SiwenJadenLong/CRB-Department-of-Donuts/Donut of Doom/KiCad Files/Donut of Doom/Other Assets/ELRS Frontside.jpg

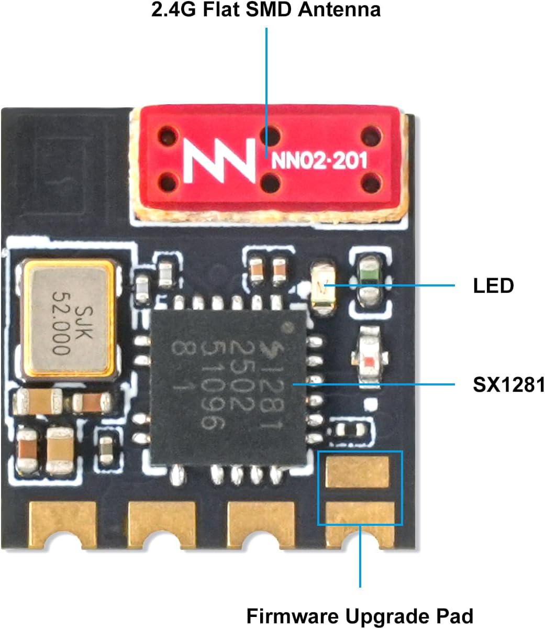
Donut of Doom/KiCad Files/Donut of Doom/Other Assets/ELRS Frontside.jpg
