SiwenJadenLong/CRB-Department-of-Donuts/Donut of Doom/CODE (openmelt2-main)/antweight_reference_platform/lid.stl

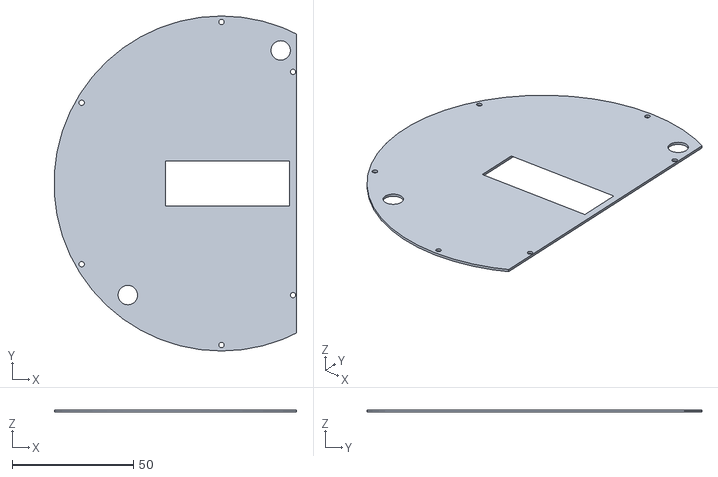
[picture p11: CAD file, 2025-09-27]
Donut of Doom/CODE (openmelt2-main)/antweight_reference_platform/lid.stl
99.9 x 138.0 x 1.00
