SiwenJadenLong/CRB-Department-of-Donuts/Donut of Doom/KiCad Files/Donut of Doom/Downloaded Libraries/H3LIS331DLTR/H3LIS331DLTR.step

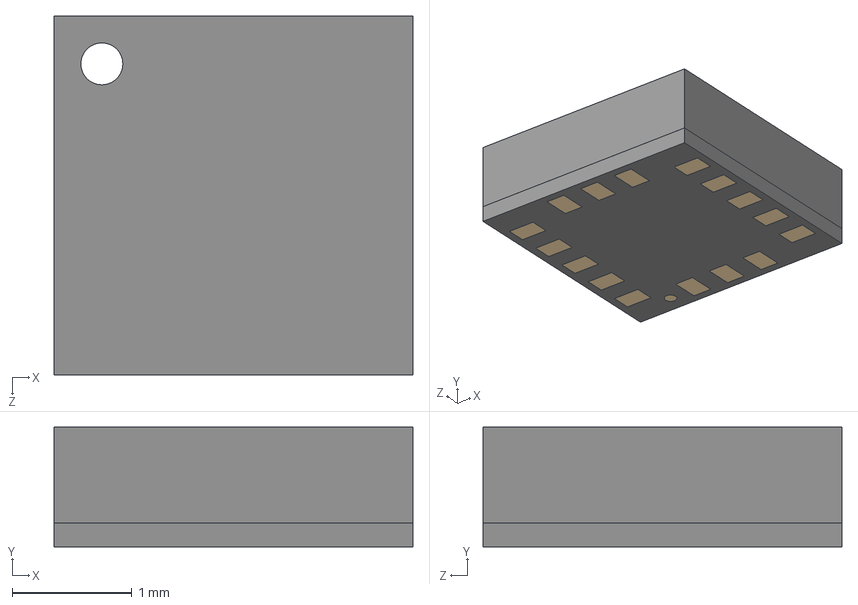
[picture p12: CAD file, 2026-01-15]
Donut of Doom/KiCad Files/Donut of Doom/Downloaded Libraries/H3LIS331DLTR/H3LIS331DLTR.step
3.00 x 1.00 x 3.00 mm
