SiwenJadenLong/CRB-Department-of-Donuts/Donut of Doom/KiCad Files/Donut of Doom/Downloaded Libraries/TL3365AF180QG/TL3365AF180QG.step

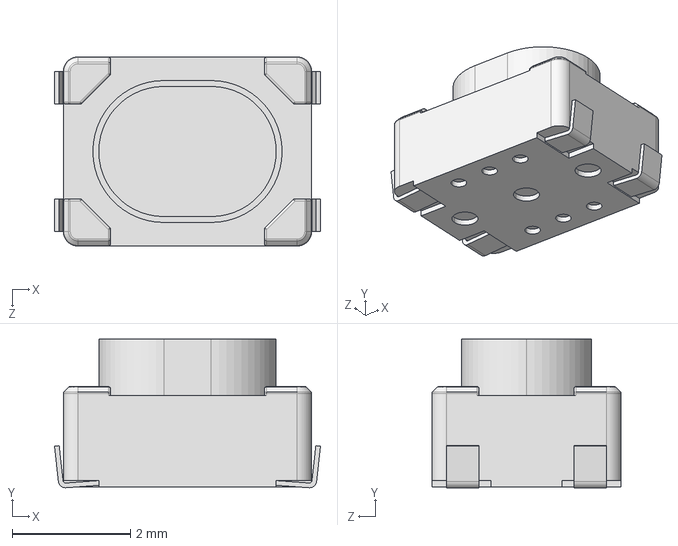
[picture p13: CAD file, 2026-01-17]
Donut of Doom/KiCad Files/Donut of Doom/Downloaded Libraries/TL3365AF180QG/TL3365AF180QG.step
4.50 x 2.51 x 3.20 mm
