SiwenJadenLong/CRB-Department-of-Donuts/Donut of Doom/KiCad Files/Donut of Doom/Downloaded Libraries/ul_MSP3V3-M3-89A/MSMP package.step

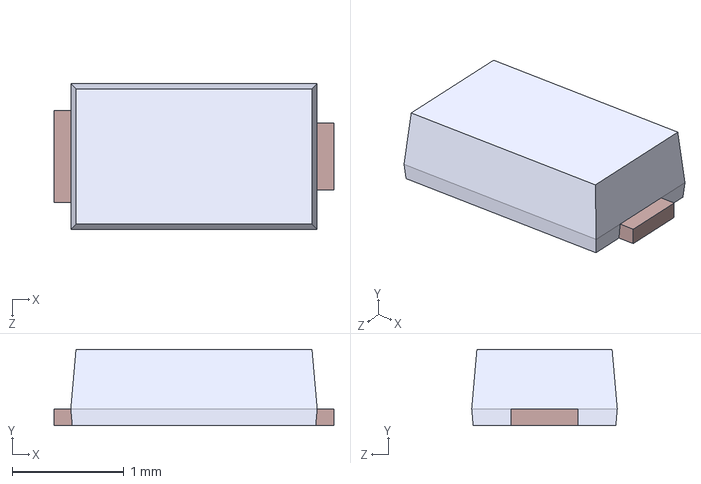
[picture p14: CAD file, 2026-01-15]
Donut of Doom/KiCad Files/Donut of Doom/Downloaded Libraries/ul_MSP3V3-M3-89A/MSMP package.step
2.50 x 0.68 x 1.30 mm
