SiwenJadenLong/CRB-Department-of-Donuts/Donut of Doom/KiCad Files/Donut of Doom/Exports/Donut of Doom Order 1.step

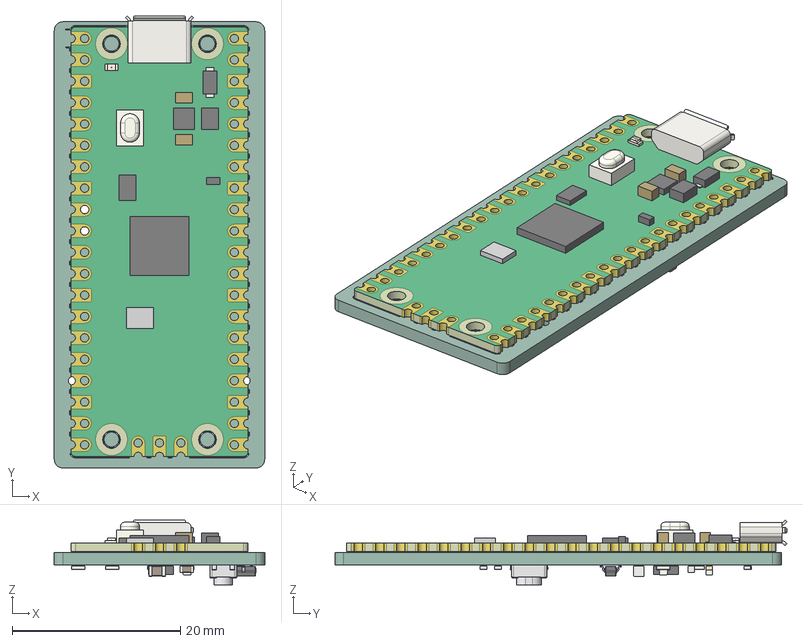
[picture p15: CAD file, 2026-01-31]
Donut of Doom/KiCad Files/Donut of Doom/Exports/Donut of Doom Order 1.step
25.0 x 53.7 x 7.70 mm
RaspberryPi_Pico
R_0603_1608Metric x 7
C_0603_1608Metric
SOT-23
LGA-16_3x3mm_P0.5mm_LayoutBorder3x5y
C_0805_2012Metric
TL3365AF180QG--3DModel-STEP-520916
LED_0603_1608Metric x 2
Donut of Doom_silkscreen
Donut of Doom_PCB
