SiwenJadenLong/CRB-Department-of-Donuts/Donut of Doom/KiCad Files/Donut of Doom/Exports/Test 1/Donut of Doom v1.step

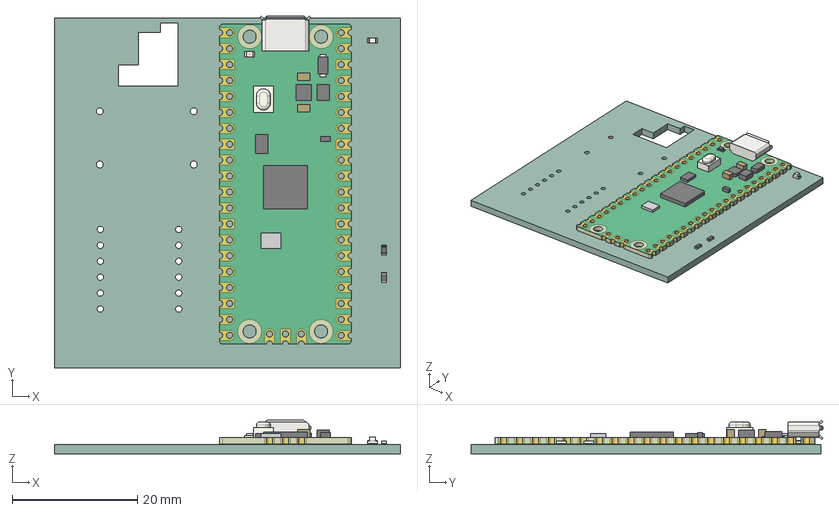
[picture p16: CAD file, 2026-01-15]
Donut of Doom/KiCad Files/Donut of Doom/Exports/Test 1/Donut of Doom v1.step
55.2 x 56.1 x 5.34 mm
RaspberryPi_Pico
R_0603_1608Metric x 2
LED_0603_1608Metric
Donut of Doom_PCB
