SiwenJadenLong/CRB-Department-of-Donuts/Donut of Doom/CODE (openmelt2-main)/antweight_reference_platform/weapon.stl

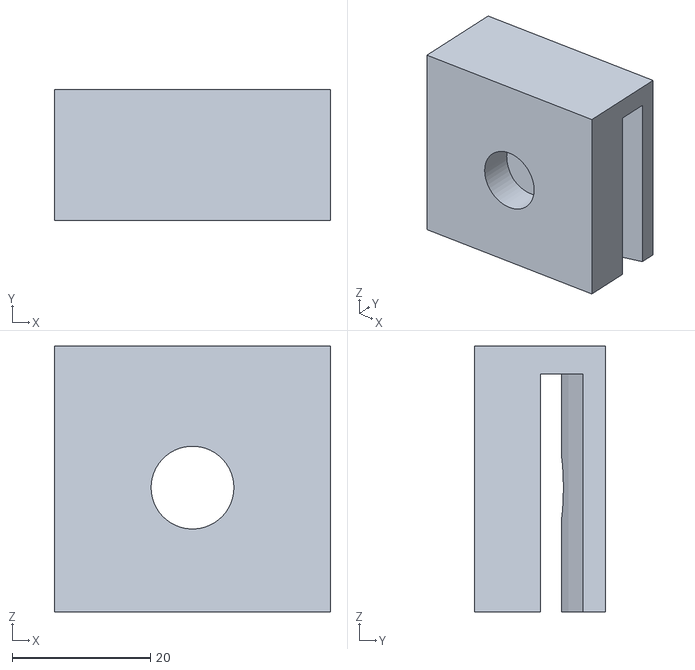
[picture p17: CAD file, 2025-09-27]
Donut of Doom/CODE (openmelt2-main)/antweight_reference_platform/weapon.stl
40.0 x 19.0 x 38.5
