SiwenJadenLong/CRB-Department-of-Donuts/Donut of Doom/CODE (openmelt2-main)/antweight_reference_platform/shell_no_weapon.stl

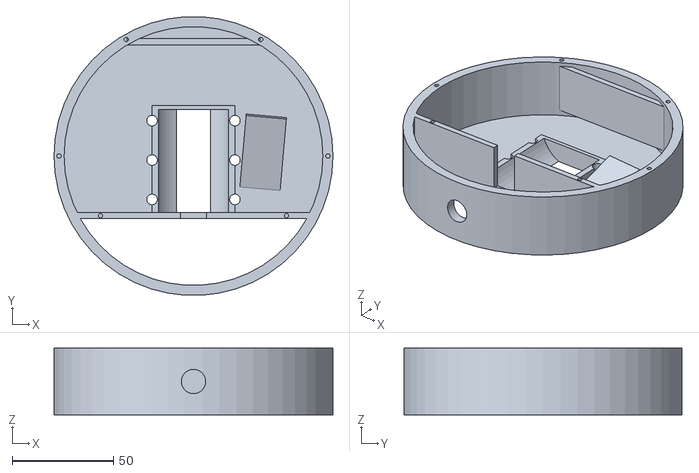
[picture p18: CAD file, 2025-09-27]
Donut of Doom/CODE (openmelt2-main)/antweight_reference_platform/shell_no_weapon.stl
138.0 x 137.7 x 33.0
