SiwenJadenLong/CRB-Department-of-Donuts/Donut of Doom/CODE (openmelt2-main)/antweight_reference_platform/shell_with_weapon.stl

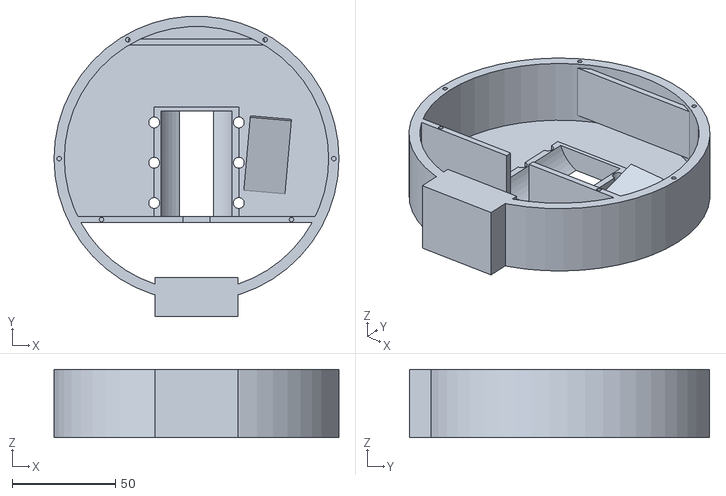
[picture p19: CAD file, 2025-09-27]
Donut of Doom/CODE (openmelt2-main)/antweight_reference_platform/shell_with_weapon.stl
138.0 x 145.4 x 33.0
