SiwenJadenLong/CRB-Department-of-Donuts/Donut of Doom/CODE (openmelt2-main)/antweight_reference_platform/weapon_pin.stl

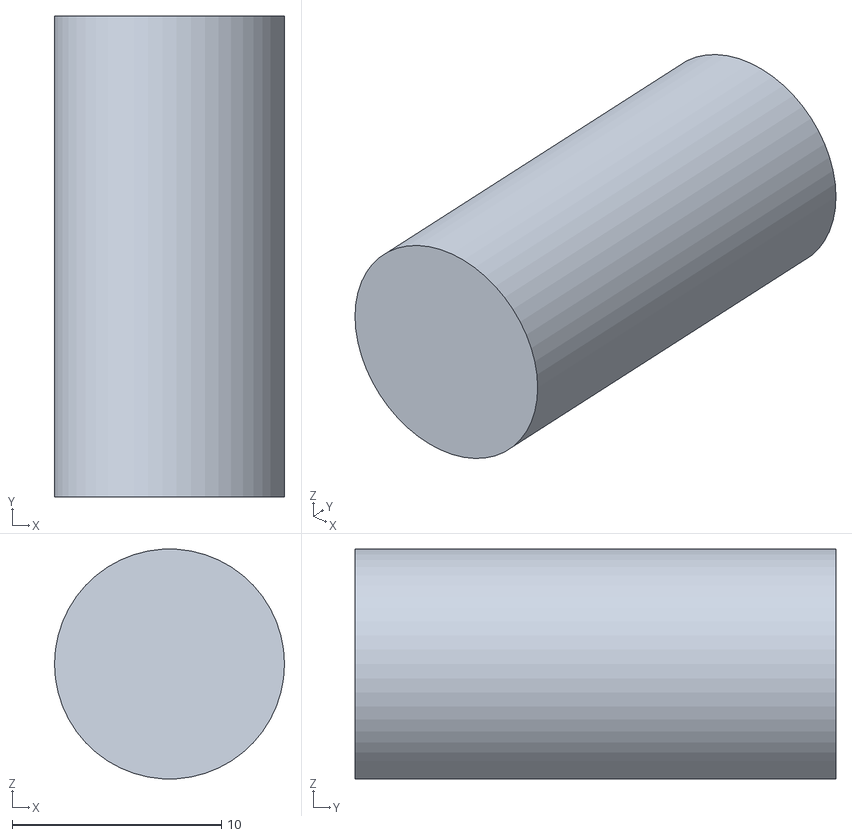
[picture p20: CAD file, 2025-09-27]
Donut of Doom/CODE (openmelt2-main)/antweight_reference_platform/weapon_pin.stl
11.0 x 23.0 x 11.0
