SiwenJadenLong/CRB-Department-of-Donuts/(list of files, cad)

Other CAD files:
Donut of Doom/CODE (openmelt2-main)/antweight_reference_platform/spinbot_ant.scad
