SiwenJadenLong/CRB-Department-of-Donuts/Donut of Doom/KiCad Files/Donut of Doom/Donut of Doom.kicad_pcb

## KiCad design Donut of Doom/KiCad Files/Donut of Doom/Donut of Doom.kicad_pcb (2026-07-06)

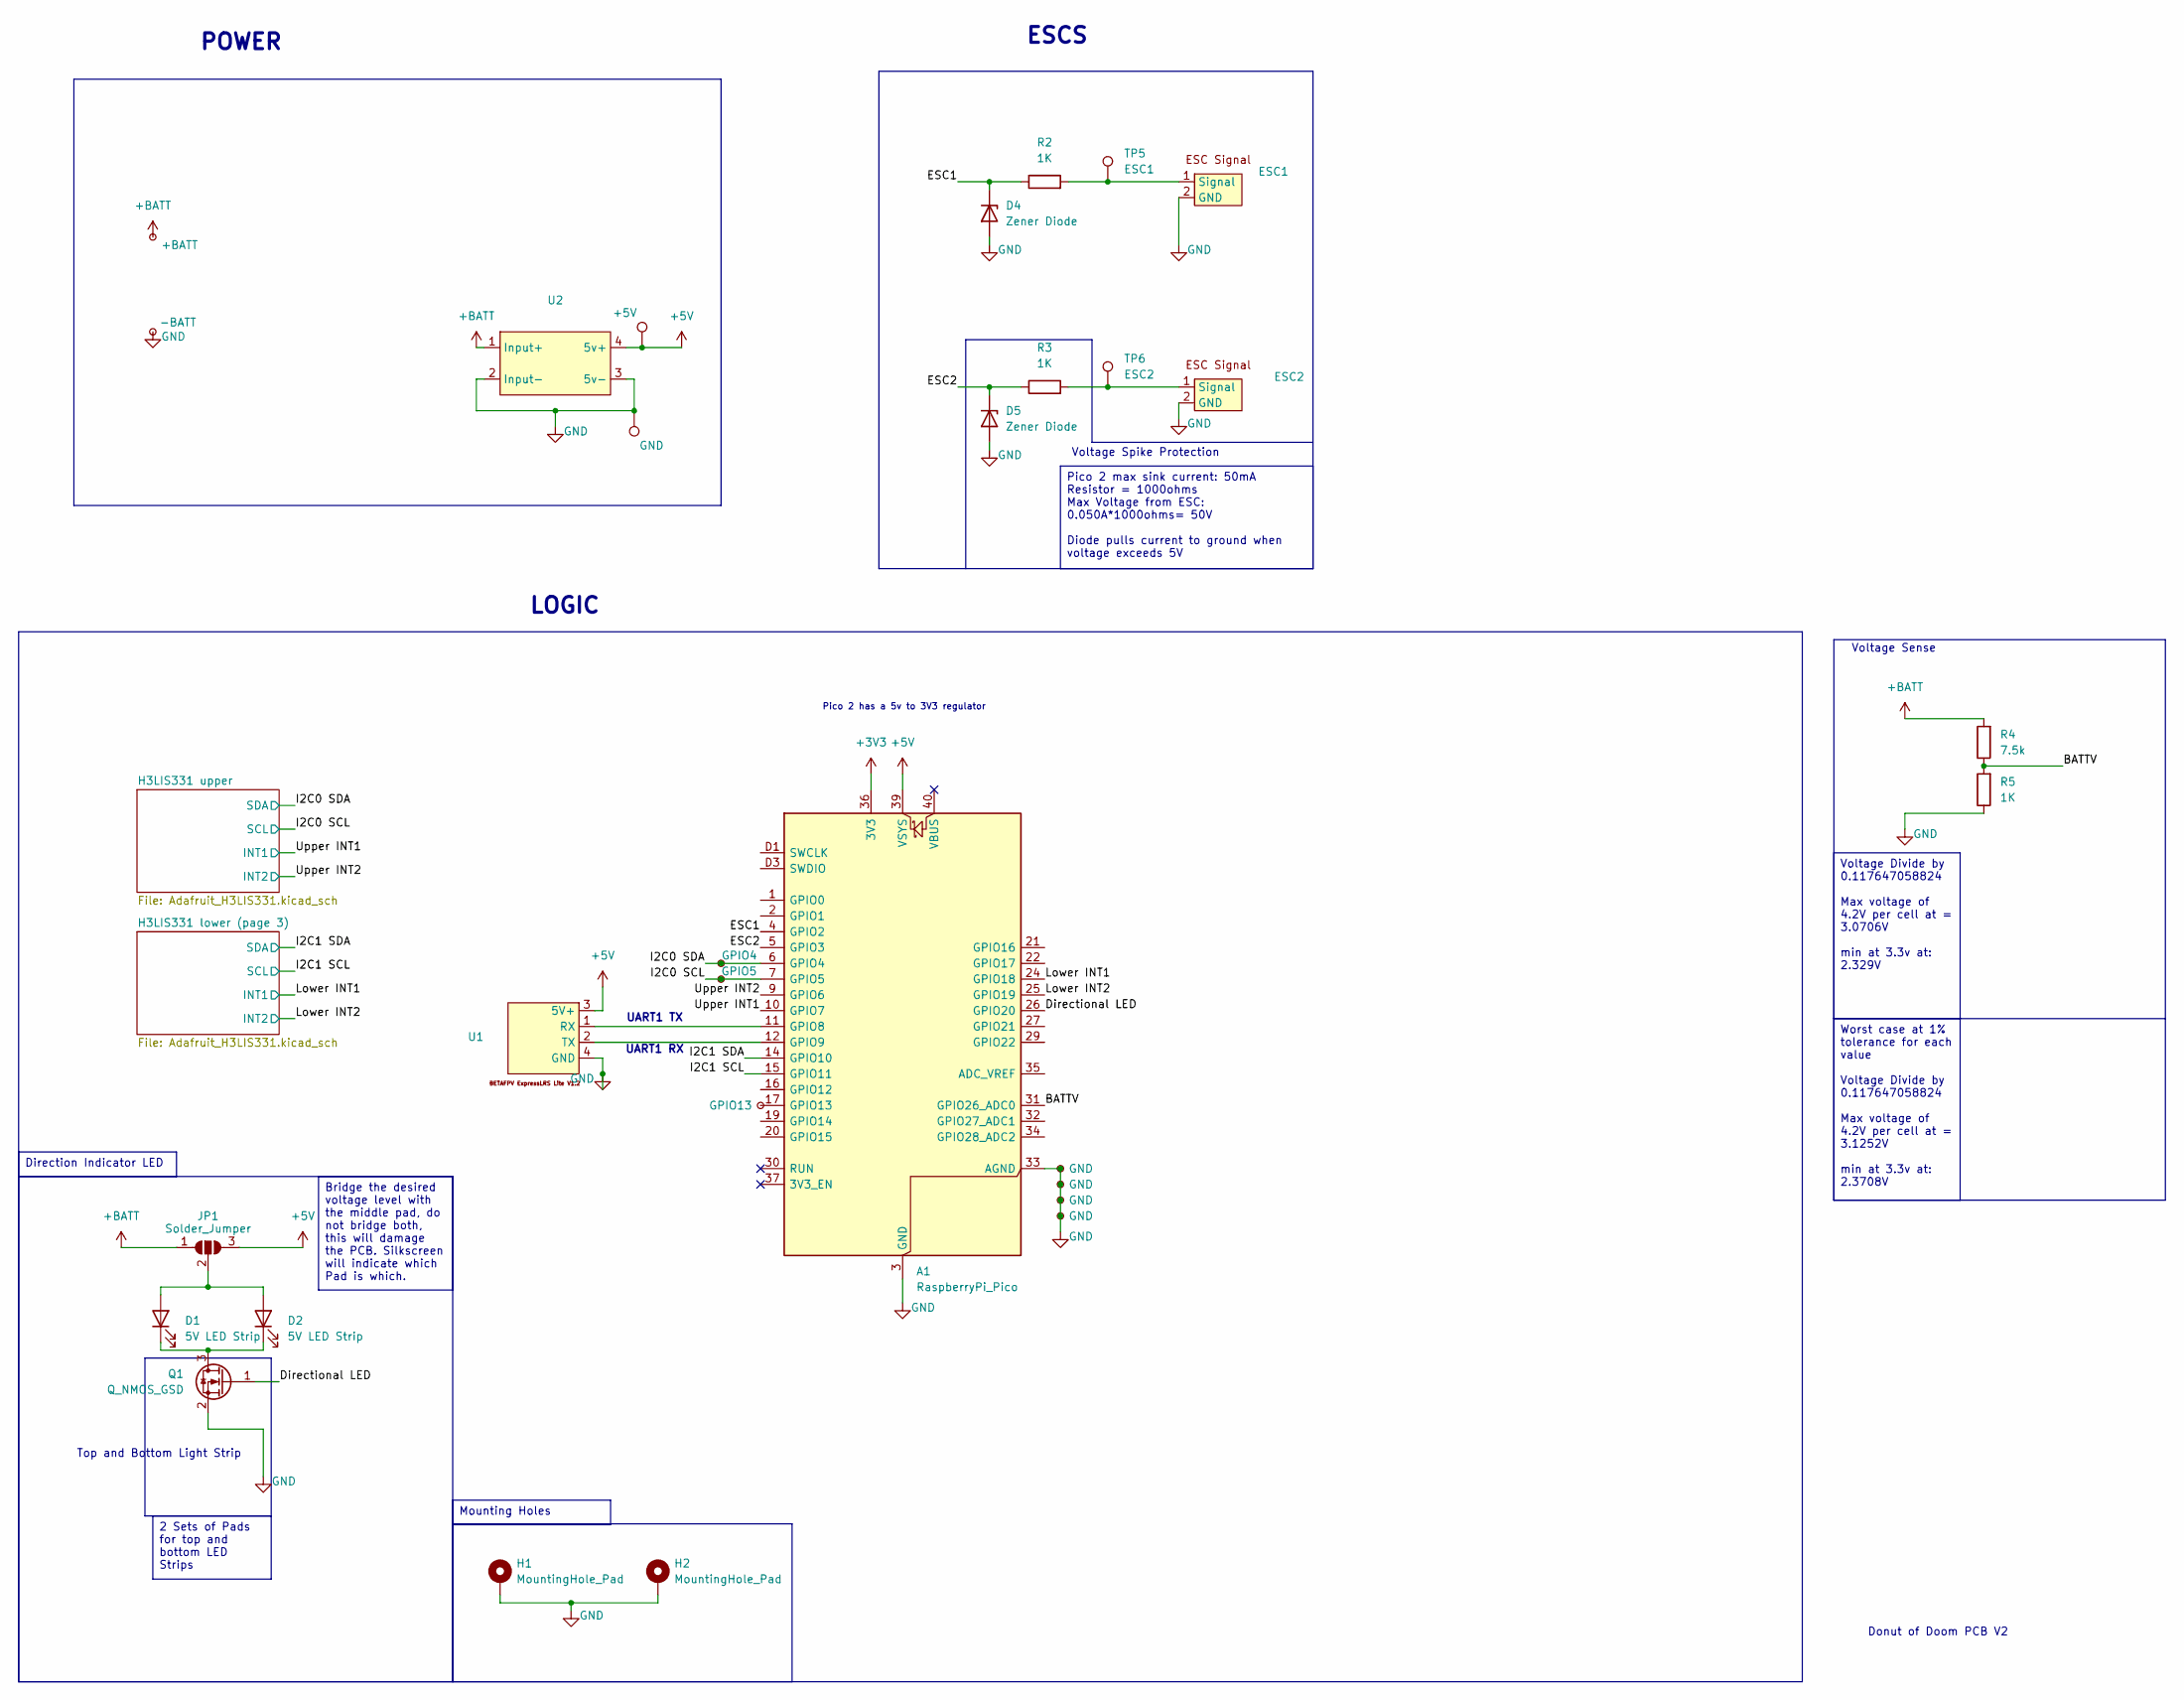
[picture p21: schematic Donut of Doom.kicad_sch]

Parts:
A1: RaspberryPi_Pico; RaspberryPi_Pico_Original_SMD_HandSolder
D1, D2: 5V LED Strip; 2 pth Pads
D4, D5: Zener Diode; SGP1610N2
ESC1, ESC2: 2_2mmx1.5mm_smd_pad
EX1: GPIO4; Pico_pth_pad
EX2: GPIO5; Pico_pth_pad
EX5: GPIO13; Pico_pth_pad
EX8, EX9, EX11, EX12: GND; Pico_pth_GND
H1, H2: MountingHole_Pad; MountingHole_2.2mm_M2_DIN965_Pad
JP1: Solder_Jumper; SolderJumper-3_P1.3mm_Open_RoundedPad1.0x1.5mm_NumberLabels
Q1: Q_NMOS_GSD; TSOT-23
R2, R3, R5: 1K; R_0603_1608Metric_Pad0.98x0.95mm_HandSolder
R4: 7.5k; R_0603_1608Metric_Pad0.98x0.95mm_HandSolder
TP1: +BATT; 3.5mmx2.5mm_oval_smd_pad
TP2: -BATT; 3.5mmx2.5mm_oval_smd_pad
TP3: GND; TestPoint_Pad_D3.0mm
TP4: +5V; TestPoint_Pad_D2.0mm
TP5: ESC1; TestPoint_Pad_D1.5mm
TP6: ESC2; TestPoint_Pad_D1.5mm
U1: BetaFPV ExpressLRS Reciever Lite V1.2
U2: 5V_Stepdown_module

Connections:
+3V3: A1.36 (3V3); also elsewhere on the board
+5V: A1.39 (VSYS), JP1.3 (B), TP4.1 (1_1), U1.3 (5V+), U2.4 (5v+)
+BATT: JP1.1 (A), R4.2, TP1.1 (1_1), U2.1 (Input+)
/BATTV: A1.31 (GPIO26_ADC0), R4.1, R5.2
/Directional LED: A1.26 (GPIO20), Q1.1 (G)
/ESC1: A1.4 (GPIO2), D4.1 (K), R2.1
/ESC2: A1.5 (GPIO3), D5.1 (K), R3.1
/I2C0 SCL: A1.7 (GPIO5), EX2.1 (1_1); also elsewhere on the board
/I2C0 SDA: A1.6 (GPIO4), EX1.1 (1_1); also elsewhere on the board
/I2C1 SCL: A1.15 (GPIO11); also elsewhere on the board
/I2C1 SDA: A1.14 (GPIO10); also elsewhere on the board
/Lower INT1: A1.24 (GPIO18); also elsewhere on the board
/Lower INT2: A1.25 (GPIO19); also elsewhere on the board
/Upper INT1: A1.10 (GPIO7); also elsewhere on the board
/Upper INT2: A1.9 (GPIO6); also elsewhere on the board
GND: A1.3 (GND), A1.8 (GND), A1.13 (GND), A1.18 (GND), A1.23 (GND), A1.28 (GND), A1.33 (AGND), A1.38 (GND), A1.D2 (GND), D4.2 (A), D5.2 (A), ESC1.2 (GND), ESC2.2 (GND), EX8.1 (1_1), EX9.1 (1_1), EX11.1 (1_1), EX12.1 (1_1), H1.1 (1_1), H2.1, Q1.2 (S), R5.1, TP2.1 (1_1), TP3.1 (1_1), U1.4 (GND), U2.2 (Input-), U2.3 (5v-); also elsewhere on the board
unnamed: A1.11 (GPIO8), U1.1 (RX)
unnamed: A1.12 (GPIO9), U1.2 (TX)
unnamed: A1.17 (GPIO13), EX5.1 (1_1)
unnamed: D1.2 (A), D2.2 (A), JP1.2 (C)
unnamed: D1.1 (K), D2.1 (K), Q1.3 (D)
unnamed: ESC1.1 (Signal), R2.2, TP5.1 (1_1)
unnamed: ESC2.1 (Signal), R3.2, TP6.1 (1_1)

Notes on the sheet:
Voltage Spike Protection
LOGIC
ESCS
UART1 RX
POWER
Pico 2 has a 5v to 3V3 regulator
Voltage Sense
Donut of Doom PCB V2
Top and Bottom Light Strip
UART1 TX
Pico 2 max sink current: 50mA Resistor = 1000ohms Max Voltage from ESC: 0.050A*1000ohms= 50V Diode pulls current to ground when voltage exceeds 5V
Worst case at 1% tolerance for each value Voltage Divide by 0.117647058824 Max voltage of 4.2V per cell at = 3.1252V min at 3.3v at: 2.3708V
Direction Indicator LED
Mounting Holes
Bridge the desired voltage level with the middle pad, do not bridge both, this will damage the PCB. Silkscreen will indicate which Pad is which.
2 Sets of Pads for top and bottom LED Strips
Voltage Divide by 0.117647058824 Max voltage of 4.2V per cell at = 3.0706V min at 3.3v at: 2.329V

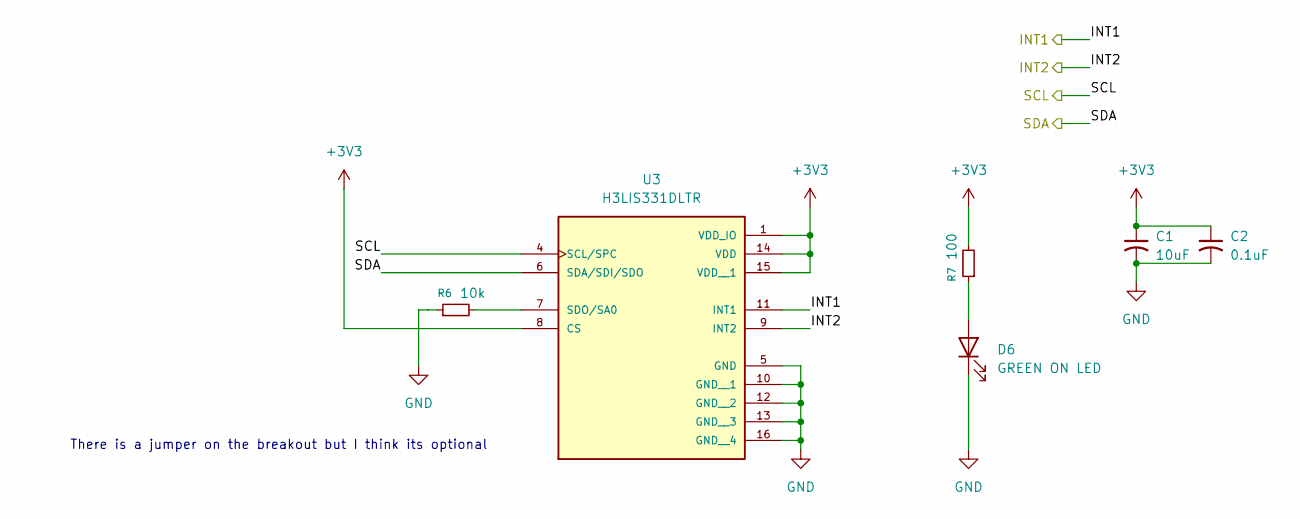
[picture p22: schematic Adafruit_H3LIS331.kicad_sch]

Parts:
C1: 10uF; C_0805_2012Metric_Pad1.18x1.45mm_HandSolder
C2: 0.1uF; C_0603_1608Metric_Pad1.08x0.95mm_HandSolder
D6: GREEN ON LED; LED_0603_1608Metric_Pad1.05x0.95mm_HandSolder
R6: 10k; R_0603_1608Metric_Pad0.98x0.95mm_HandSolder
R7: 100; R_0603_1608Metric_Pad0.98x0.95mm_HandSolder
U3: H3LIS331DLTR; LGA-16_3x3mm_P0.5mm_LayoutBorder3x5y

Connections:
+3V3: C1.1, C2.1, R7.2, U3.1 (VDD_IO), U3.8 (CS), U3.14 (VDD), U3.15 (VDD__1); also elsewhere on the board
/I2C0 SCL: U3.4 (SCL/SPC); also elsewhere on the board
/I2C0 SDA: U3.6 (SDA/SDI/SDO); also elsewhere on the board
/Upper INT1: U3.11 (INT1); also elsewhere on the board
/Upper INT2: U3.9 (INT2); also elsewhere on the board
GND: C1.2, C2.2, D6.1 (K), R6.1, U3.5 (GND), U3.10 (GND__1), U3.12 (GND__2), U3.13 (GND__3), U3.16 (GND__4); also elsewhere on the board
unnamed: D6.2 (A), R7.1
unnamed: R6.2, U3.7 (SDO/SA0)

Parts of its further copies:
C3: 10uF; C_0805_2012Metric_Pad1.18x1.45mm_HandSolder
C4: 0.1uF; C_0603_1608Metric_Pad1.08x0.95mm_HandSolder
D7: GREEN ON LED; LED_0603_1608Metric_Pad1.05x0.95mm_HandSolder
R8: 10k; R_0603_1608Metric_Pad0.98x0.95mm_HandSolder
R9: 100; R_0603_1608Metric_Pad0.98x0.95mm_HandSolder
U4: H3LIS331DLTR; LGA-16_3x3mm_P0.5mm_LayoutBorder3x5y

Connections of its further copies:
+3V3: C3.1, C4.1, R9.2, U4.1 (VDD_IO), U4.8 (CS), U4.14 (VDD), U4.15 (VDD__1); also elsewhere on the board
/I2C1 SCL: U4.4 (SCL/SPC); also elsewhere on the board
/I2C1 SDA: U4.6 (SDA/SDI/SDO); also elsewhere on the board
/Lower INT1: U4.11 (INT1); also elsewhere on the board
/Lower INT2: U4.9 (INT2); also elsewhere on the board
GND: C3.2, C4.2, D7.1 (K), R8.1, U4.5 (GND), U4.10 (GND__1), U4.12 (GND__2), U4.13 (GND__3), U4.16 (GND__4); also elsewhere on the board
unnamed: D7.2 (A), R9.1
unnamed: R8.2, U4.7 (SDO/SA0)

Notes on the sheet:
There is a jumper on the breakout but I think its optional

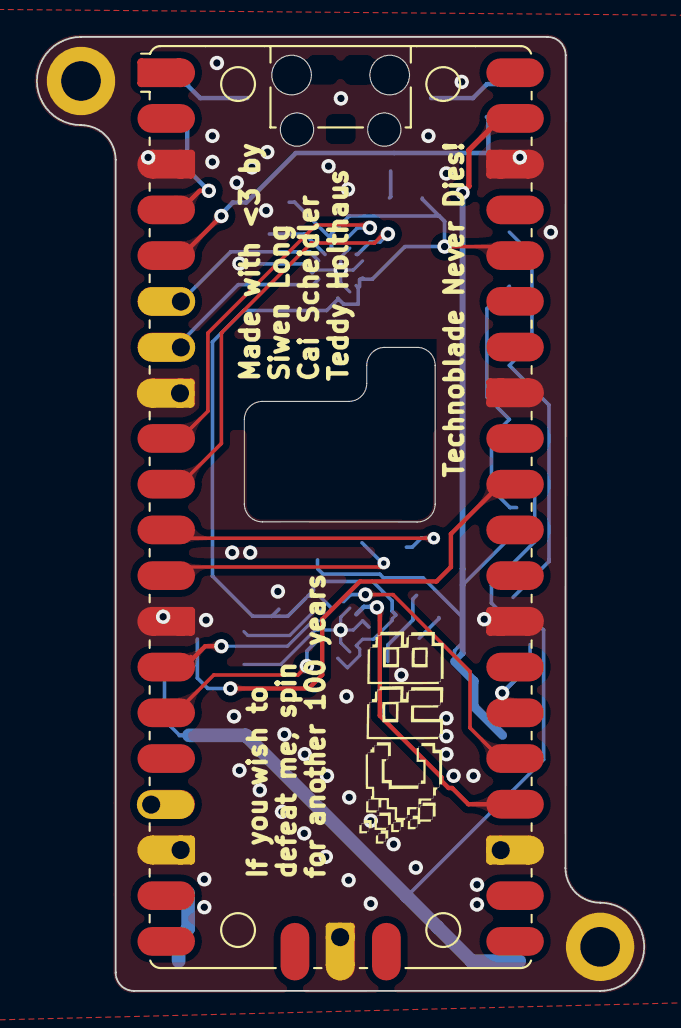
[picture p23: board Donut of Doom.kicad_pcb from above]

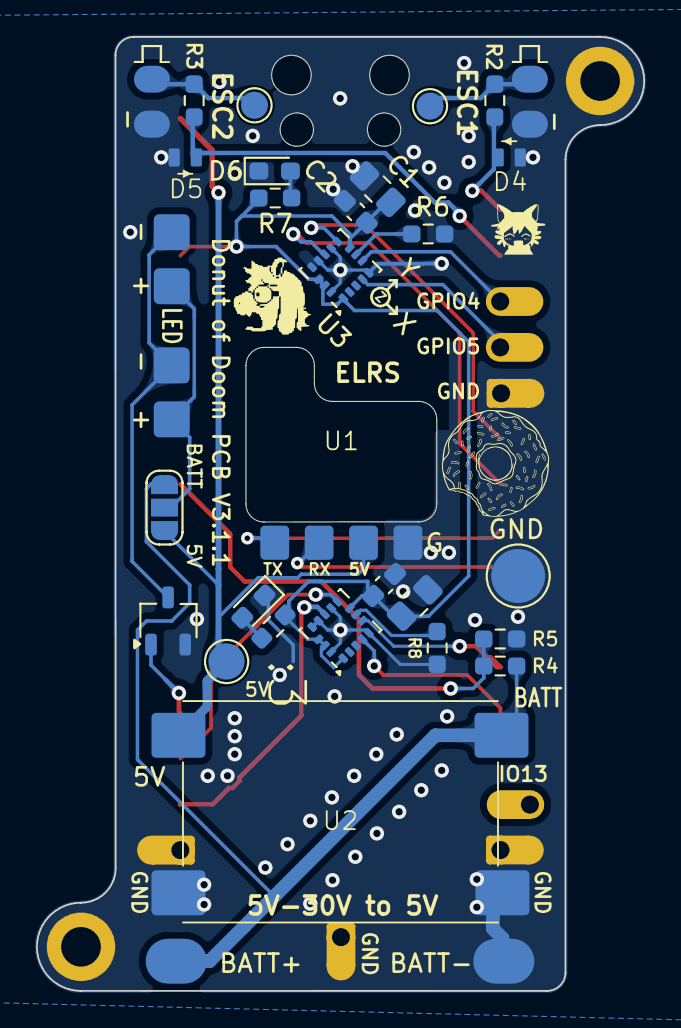
[picture p24: board Donut of Doom.kicad_pcb from below]

Board: 2 copper layers, 33.7 x 53.0 mm, 42 parts (32 on the bottom side), 27 nets.

Other parts of the board:
H1#2: MountingHole_Pad; MountingHole_2.2mm_M2_DIN965_Pad

Their connections:
GND: H1#2.1 (1_1); also elsewhere on the board
