SiwenJadenLong/CRB-Department-of-Donuts/Donut of Doom/CODE (openmelt2-main)/openmelt/melty_config.h

#include <SparkFun_LIS331.h>

#include <FastIMU.h>

#include <Adafruit_SleepyDog.h>

//This file is intended to include all commonly modified settings for Open Melt

#ifndef MELTY_CONFIG_GUARD  //header guard
#define MELTY_CONFIG_GUARD

//----------AVR SPECIFIC FUNCTIONALITY----------
//This code has not been tested on ARM / non-AVR Arduinos (but may work)
//Doesn't currently support persistent config storage for non-AVR Arduinos (see config_storage.cpp for details)
//490Hz PWM-throttle behavior is specific to Atmega32u4 (see below)

//----------DIAGNOSTICS----------
//#define JUST_DO_DIAGNOSTIC_LOOP                 //Disables the robot / just displays config / battery voltage / RC info via serial

//----------EEPROM----------
//#define ENABLE_EEPROM_STORAGE                     //Comment out this to disable EEPROM (for ARM)
#define EEPROM_WRITTEN_SENTINEL_VALUE 42          //Changing this value will cause existing EEPROM values to be invalidated (revert to defaults)

//----------TRANSLATIONAL DRIFT SETTINGS----------
//"DEFAULT" values are overriden by interactive config / stored in EEPROM (interactive config will be easier if they are about correct)
//To force these values to take effect after interactive config - increment EEPROM_WRITTEN_SENTINEL_VALUE
#define DEFAULT_ACCEL_MOUNT_RADIUS_CM 4.45         //Radius of accelerometer from center of robot
#define DEFAULT_LED_OFFSET_PERCENT 7              //Adjust to make heading LED line up with direction robot travels 0-99 (increasing moves beacon clockwise)
                                                   
#define DEFAULT_ACCEL_ZERO_G_OFFSET 1.5f          //Value accelerometer returns with robot at rest (in G) - adjusts for any offset
                                                  //H3LIS331 claims +/-1g DC offset - typical - but +/-2.5 has been observed at +/-400g setting (enough to cause tracking error)
                                                  //Just enterring and exiting config mode will automatically set this value / save to EEPROM (based on current accel reading reflecting 0g)
                                                  //For small-radius bots - try changing to H3LIS331 to +/-200g range for improved accuracy (accel_handler.h)

#define LEFT_RIGHT_HEADING_CONTROL_DIVISOR 1.5f   //How quick steering is (larger values = slower)

#define MIN_TRANSLATION_RPM 400                   //full power spin in below this number (increasing can reduce spin-up time)


//----------PIN MAPPINGS----------
//RC pins must be Arduino interrupt pins
//we need 3 interrupt pins - which requires an Arduino with Atmega32u4 or better (Atmega328 only support 2 interrupts)
//Common RC receiver setup LEFTRIGHT = CH1, FORBACK = CH2, THROTTLE = CH3
//Note: Accelerometer is connected with default Arduino SDA / SCL pins

#define LEFTRIGHT_RC_CHANNEL_PIN 4 // Channel 1, Purple                 //To Left / Right on RC receiver
#define FORBACK_RC_CHANNEL_PIN 5 // Channel 2, White                    //To Forward / Back on RC receiver (Pin 1 on Arduino Micro labelled as "TX" - https://docs.arduino.cc/hacking/hardware/PinMapping32u4)
#define THROTTLE_RC_CHANNEL_PIN 17 // Channel 4, Yellow                 //To Throttle on RC receiver (Pin 0 on Arduino Micro labelled as "RX" - https://docs.arduino.cc/hacking/hardware/PinMapping32u4)
#define KILLSWITCH_RC_CHANNEL_PIN 16 // Channel 3, Brown

#define HEADING_LED_PIN	2                         //To heading LED (pin 13 is on-board Arduino LED)

//no configuration changes are needed if only 1 motor is used!
#define MOTOR_PIN1 18 // Mustard                             //Pin for Motor 1 driver
#define MOTOR_PIN2 19 // Also Mustard                            //Pin for Motor 2 driver

#define BATTERY_ADC_PIN A0                        //Pin for battery monitor (if enabled)


//----------THROTTLE CONFIGURATION----------
//THROTTLE_TYPE / High-speed PWM motor driver support: b
//Setting THROTTLE_TYPE to FIXED_PWM_THROTTLE or DYNAMIC_PWM_THROTTLE pulses 490Hz PWM signal on motor drive pins at specified duty cycle (0-255)
//Can be used for 2 possible purposes:
//  1. Used as control signal for a brushless ESC supporting high speed (490Hz) PWM (tested with Hobbypower 30A / "Simonk" firmware)
//          Assumes Arduino PWM output is 490Hz (such as Arduino Micro pins 9 and 10) - should be expected NOT to work with non-AVR Arduino's without changes
//  2. 490hz signal maybe fed into a MOSFET or other on / off motor driver to control drive strength (relatively low frequency)
//Thanks to Richard Wong for his research in implementing brushless ESC support

enum throttle_modes {
  BINARY_THROTTLE,      //Motors pins are fully on/off - throttle controlled by portion of each rotation motor is on (no PWM)

  FIXED_PWM_THROTTLE,   //Motors pins are PWM at PWM_MOTOR_ON, PWM_MOTOR_COAST or PWM_MOTOR_OFF
                        //throttle controlled by portion of each rotation motor is on

  DYNAMIC_PWM_THROTTLE  //Scales PWM throttling between PWM_MOTOR_COAST and PWM_MOTOR_ON
                        //Range of throttle scaled over is determined by DYNAMIC_PWM_THROTTLE_PERCENT_MAX
                        //PWM is locked at PWM_MOTOR_ON for throttle positions higher than DYNAMIC_PWM_THROTTLE_PERCENT_MAX
                        //Robot speed is additionally controlled by portion of each rotation motor is on (unless DYNAMIC_PWM_MOTOR_ON_PORTION is defined)
                        //This mode reduces current levels during spin up at part throttle
};

#define THROTTLE_TYPE FIXED_PWM_THROTTLE      //<---Throttle type set here!

#define DYNAMIC_PWM_MOTOR_ON_PORTION 0.75f       //if defined (and DYNAMIC_PWM_THROTTLE is set) portion of each rotation motor is on is fixed at this value
                                                //About 0.5f for best translation (higher for increased RPM)

#define DYNAMIC_PWM_THROTTLE_PERCENT_MAX 0.5f   //Range of RC throttle DYNAMIC_PWM_THROTTLE is applied to 
                                                //0.5f for 0-50% throttle (full PWM_MOTOR_ON used for >50% throttle)
                                                //1.0f for 0-100% throttle

//----------PWM MOTOR SETTINGS---------- 
//(only used if a PWM throttle mode is chosen)
//PWM values are 0-255 duty cycle
#define PWM_MOTOR_ON 31                          //Motor PWM ON duty cycle (Simonk: 140 seems barely on / 230 seems a good near-full-throttle value)
#define PWM_MOTOR_COAST 15                      //Motor PWM COAST duty cycle - set to same as PWM_ESC_MOTOR_OFF for fully unpowered (best translation?)
#define PWM_MOTOR_OFF 15                        //Motor PWM OFF duty cycle (Simonk: 100 worked well in testing - if this is too low - ESC may not init)


//----------BATTERY MONITOR----------
#define BATTERY_ALERT_ENABLED                     //if enabled - heading LED will flicker when battery voltage is low
#define VOLTAGE_DIVIDER 11                        //(~10:1 works well - 10kohm to GND, 100kohm to Bat+).  Resistors have tolerances!  Adjust as needed...
#define BATTERY_ADC_WARN_VOLTAGE_THRESHOLD 7.0f  //If voltage drops below this value - then alert is triggered
#define ARDUINIO_VOLTAGE 5.0f                     //Needed for ADC maths for battery monitor
#define LOW_BAT_REPEAT_READS_BEFORE_ALARM 20      //Requires this many ADC reads below threshold before alarming


//----------SAFETY----------
#define ENABLE_WATCHDOG                           //Uses Adafruit's sleepdog to enable watchdog / reset (tested on AVR - should work for ARM https://github.com/adafruit/Adafruit_SleepyDog)
#define WATCH_DOG_TIMEOUT_MS 2000                 //Timeout value for watchdog (not all values are supported - 2000ms verified with Arudino Micro)
#define VERIFY_RC_THROTTLE_ZERO_AT_BOOT           //Requires RC throttle be 0% at boot to allow spin-up for duration of MAX_MS_BETWEEN_RC_UPDATES (about 1 second)
                                                  //Intended as safety feature to prevent bot from spinning up at power-on if RC was inadvertently left on.
                                                  //Downside is if unexpected reboot occurs during a fight - driver will need to set throttle to zero before power 

#endif
