SiwenJadenLong/CRB-Department-of-Donuts/Donut of Doom/CODE (openmelt2-main)/openmelt/spin_control.cpp

//this module handles calculation and timing loop for translational drift
//direction of rotation assumed to be CLOCKWISE (but should work counter-clockwise)

#include "arduino.h"
#include "melty_config.h"
#include "motor_driver.h"
#include "rc_handler.h"
#include "spin_control.h"
#include "accel_handler.h"
#include "config_storage.h"
#include "led_driver.h"
#include "battery_monitor.h"

#define ACCEL_MOUNT_RADIUS_MINIMUM_CM 0.2                 //Never allow interactive config to set below this value
#define LEFT_RIGHT_CONFIG_RADIUS_ADJUST_DIVISOR 50.0f     //How quick accel. radius is adjusted in config mode (larger values = slower)
#define LEFT_RIGHT_CONFIG_LED_ADJUST_DIVISOR 0.1f         //How quick LED heading is adjusted in config mode (larger values = slower)

#define MAX_TRANSLATION_ROTATION_INTERVAL_US (1.0f / MIN_TRANSLATION_RPM) * 60 * 1000 * 1000
#define MAX_TRACKING_ROTATION_INTERVAL_US MAX_TRANSLATION_ROTATION_INTERVAL_US * 2   //don't track heading if we are this slow (also puts upper limit on time spent in melty loop for safety)

static float accel_mount_radius_cm = DEFAULT_ACCEL_MOUNT_RADIUS_CM;
static float accel_zero_g_offset = DEFAULT_ACCEL_ZERO_G_OFFSET;
static float led_offset_percent = DEFAULT_LED_OFFSET_PERCENT;         //stored in EEPROM as an INT - but handled as a float for configuration purposes

static unsigned int highest_rpm = 0;
static bool config_mode = false;   //1 if we are in config mode

//loads settings from EEPROM
void load_melty_config_settings() {
#ifdef ENABLE_EEPROM_STORAGE 
  accel_mount_radius_cm = load_accel_mount_radius();
  accel_zero_g_offset = load_accel_zero_g_offset();
  led_offset_percent = load_heading_led_offset();
  // Serial.println("LOADING CONFIGURED SETTINGS FROM EEPROM!");
  // Serial.print("accel_mount_radius_cm: "); Serial.println(accel_mount_radius_cm);
  // Serial.print("accel_zero_g_offset: "); Serial.println(accel_zero_g_offset);
  // Serial.print("led_offset_percent: "); Serial.println(led_offset_percent);
#endif  
}

//saves settings to EEPROM
void save_melty_config_settings() {
#ifdef ENABLE_EEPROM_STORAGE 
  save_settings_to_eeprom(led_offset_percent, accel_mount_radius_cm, accel_zero_g_offset);
#endif  
}

//updated the expected accelerometer reading for 0g 
//assumes robot is not spinning when config mode is entered
//value saved to EEPROM on config mode exit
static void update_accel_zero_g_offset(){
  int offset_samples = 200;
  for (int accel_sample_loop = 0; accel_sample_loop < offset_samples; accel_sample_loop ++) {
    accel_zero_g_offset += get_accel_force_g();
  }
  accel_zero_g_offset = accel_zero_g_offset / offset_samples;
}

void toggle_config_mode() {
  config_mode = !config_mode;

  //on entering config mode - update the zero g offset
  if (config_mode) update_accel_zero_g_offset();
  
  //enterring or exiting config mode also resets highest observed RPM
  highest_rpm = 0;
}

bool get_config_mode() {
  return config_mode;
}

int get_max_rpm() {
  return highest_rpm;
}

//calculates time for this rotation of robot
//robot is steered by increasing / decreasing rotation by factor relative to RC left / right position
//ie - reducing rotation time estimate below actual results in shift of heading opposite the direction of rotation
static float get_rotation_interval_ms(int steering_disabled) {
  
  float radius_adjustment_factor = 0;

  //don't adjust steering if disabled by config mode - or we are in RC deadzone
  if (steering_disabled == 0 && rc_get_is_lr_in_normal_deadzone() == false) {
    radius_adjustment_factor = (float)(rc_get_leftright() / (float)NOMINAL_PULSE_RANGE) / LEFT_RIGHT_HEADING_CONTROL_DIVISOR;
  }
  
  float effective_radius_in_cm = accel_mount_radius_cm;// + 4 * (float)(rc_get_leftright()/500.0f);
  //Serial.print("effective_radius_in_cm: "); Serial.println(effective_radius_in_cm);
  
  effective_radius_in_cm = effective_radius_in_cm + (effective_radius_in_cm * radius_adjustment_factor);

  float rpm;
  //use of absolute makes it so we don't need to worry about accel orientation
  //calculate RPM from g's - derived from "G = 0.00001118 * r * RPM^2"
  rpm = fabs(get_accel_force_g() - accel_zero_g_offset) * 89445.0f;
  //rpm = fabs(25 - accel_zero_g_offset) * 89445.0f;
  rpm = rpm / effective_radius_in_cm;
  rpm = sqrt(rpm);

  if (rpm > highest_rpm || highest_rpm == 0) highest_rpm = rpm;

  float rotation_interval = (1.0f / rpm) * 60 * 1000;
  return rotation_interval;
}


//performs changes to melty parameters when in config mode
static struct melty_parameters_t handle_config_mode(struct melty_parameters_t melty_parameters) {

  //if forback forward - normal drive (for driver testing - no adjustment of melty parameters)

  //if forback neutral - then do radius adjustment
  Serial.println("HANDLING CONFIG MODE");
  if (melty_parameters.translate_forback == RC_FORBACK_NEUTRAL) {
      Serial.println("ADJUSTING ACCEL RADIUS");
    //radius adjustment overrides steering
    melty_parameters.steering_disabled = 1;

    //only adjust if stick is outside deadzone    
    if (rc_get_is_lr_in_config_deadzone() == false) {
      //show that we are changing config
      melty_parameters.led_shimmer = 1;

      float adjustment_factor = (accel_mount_radius_cm * (float)(rc_get_leftright() / (float)NOMINAL_PULSE_RANGE));
      adjustment_factor = adjustment_factor / LEFT_RIGHT_CONFIG_RADIUS_ADJUST_DIVISOR;
      accel_mount_radius_cm = accel_mount_radius_cm + adjustment_factor;
      Serial.println("REALLY ADJUSTING ACCEL RADIUS");
      Serial.print("accel_mount_radius_cm: "); Serial.println(accel_mount_radius_cm);

      if (accel_mount_radius_cm < ACCEL_MOUNT_RADIUS_MINIMUM_CM) accel_mount_radius_cm = ACCEL_MOUNT_RADIUS_MINIMUM_CM;
    }    
  }
  
  //if forback backward - do LED heading adjustment (don't translate)
  if (melty_parameters.translate_forback == RC_FORBACK_BACKWARD) {
    Serial.println("ADJUSTING LED HEADING");
    //LED heading offset adjustment overrides steering
    melty_parameters.steering_disabled = 1;
    
    //only adjust if stick is outside deadzone  
    if (rc_get_is_lr_in_config_deadzone() == false) {

      //disable translation if adjusting heading
      melty_parameters.translate_forback = RC_FORBACK_NEUTRAL;

      //show that we are changing config
      melty_parameters.led_shimmer = 1;

      float adjustment_factor =  (float)(rc_get_leftright() / (float)NOMINAL_PULSE_RANGE);
      adjustment_factor = adjustment_factor / LEFT_RIGHT_CONFIG_LED_ADJUST_DIVISOR;
      led_offset_percent = led_offset_percent + adjustment_factor;

      Serial.println("REALLY ADJUSTING LED HEADING");
      Serial.print("led_offset_percent: "); Serial.println(led_offset_percent);

      if (led_offset_percent > 99) led_offset_percent = 0;
      if (led_offset_percent < 0) led_offset_percent = 99;

    }
  }    
  return melty_parameters;  
}

//Calculates all parameters need for a single rotation (motor timing, LED timing, etc.)
//This entire section takes ~1300us on an Atmega32u4 (acceptable - fast enough to not have major impact on tracking accuracy)
static struct melty_parameters_t get_melty_parameters(void) {

  struct melty_parameters_t melty_parameters = {};

  float led_offset_portion = led_offset_percent / 100.0f;

  melty_parameters.throttle_percent = rc_get_throttle_percent() / 100.0f;

  //by default motor_on_portion maps to thottle_percent input - but that can be altered
  float motor_on_portion = melty_parameters.throttle_percent;

  //changes motor_on_portion to fixed value if we are throttling via PWM if DYNAMIC_PWM_MOTOR_ON_PORTION is defined
#ifdef DYNAMIC_PWM_MOTOR_ON_PORTION
  if (THROTTLE_TYPE == DYNAMIC_PWM_THROTTLE) {
    motor_on_portion = DYNAMIC_PWM_MOTOR_ON_PORTION;
  }
#endif 

  float led_on_portion = melty_parameters.throttle_percent;  //LED width changed with throttle percent
  if (led_on_portion < 0.10f) led_on_portion = 0.10f;
  if (led_on_portion > 0.90f) led_on_portion = 0.90f;

  melty_parameters.translate_forback = rc_get_forback();

  //if we are in config mode - handle it (and disable steering if needed)
  if (get_config_mode() == true) {
    melty_parameters = handle_config_mode(melty_parameters);
  }

  melty_parameters.rotation_interval_us = get_rotation_interval_ms(melty_parameters.steering_disabled) * 1000;
  
  //if under defined RPM - just try to spin up (motors on for full rotation)
  // if (melty_parameters.rotation_interval_us > MAX_TRANSLATION_ROTATION_INTERVAL_US){
  //   heading_led_on(0);
  //   motor_on_portion = 1;
  // } 

  //if we are too slow - don't even try to track heading
  // if (melty_parameters.rotation_interval_us > MAX_TRACKING_ROTATION_INTERVAL_US) {
  //   melty_parameters.rotation_interval_us = MAX_TRACKING_ROTATION_INTERVAL_US;
  // }

  unsigned long motor_on_us = motor_on_portion * melty_parameters.rotation_interval_us;
  unsigned long led_on_us = led_on_portion * melty_parameters.rotation_interval_us;
  unsigned long led_offset_us = led_offset_portion * melty_parameters.rotation_interval_us;

  //starts LED on time at point in rotation so it's "centered" on led offset
  if (led_on_us / 2 <= led_offset_us) {
    melty_parameters.led_start = led_offset_us - (led_on_us / 2);
  } else {
    melty_parameters.led_start = (melty_parameters.rotation_interval_us + led_offset_us) - (led_on_us / 2);
  }
  
  melty_parameters.led_stop = melty_parameters.led_start + led_on_us;

  //"wraps" led off time if it exceeds rotation length
  if (melty_parameters.led_stop > melty_parameters.rotation_interval_us)
    melty_parameters.led_stop = melty_parameters.led_stop - melty_parameters.rotation_interval_us;

  //phase 1 timing: for motor_1 in forward translation or motor_2 in reverse
  //motor "on" period is centered at the halfway point of the rotation cycle (6 o'clock)
  melty_parameters.motor_start_phase_1 = (melty_parameters.rotation_interval_us / 2) - (motor_on_us / 2);
  melty_parameters.motor_stop_phase_1 = melty_parameters.motor_start_phase_1 + motor_on_us;

  //phase 2 timing: for motor_2 in forward translation or motor_1 in reverse
  //180-degree phase shift relative to phase 1, centering the "on" period at the cycle's start/end (12 o'clock)
  melty_parameters.motor_start_phase_2 = melty_parameters.rotation_interval_us - (motor_on_us / 2);
  melty_parameters.motor_stop_phase_2 = motor_on_us / 2;

  //if the battery voltage is low - shimmer the LED to let user know
#ifdef BATTERY_ALERT_ENABLED
  if (battery_voltage_low() == true) melty_parameters.led_shimmer = 1;
#endif

  return melty_parameters;
}

//handle translating forward
static void translate_forward(struct melty_parameters_t melty_parameters, unsigned long time_spent_this_rotation_us) {
  Serial.println("TRANSLATING FORWARD!");
  if (time_spent_this_rotation_us >= melty_parameters.motor_start_phase_1 && time_spent_this_rotation_us <= melty_parameters.motor_stop_phase_1) {
    Serial.println("MOTOR 1 FORWARD ON!");
    Serial.print("time_spent_this_rotation_us"); Serial.println(time_spent_this_rotation_us);
    Serial.print("melty_parameters.motor_start_phase_1: "); Serial.println(melty_parameters.motor_start_phase_1);
    Serial.print("melty_parameters.motor_stop_phase_1: "); Serial.println(melty_parameters.motor_stop_phase_1);
    motor_1_on(melty_parameters.throttle_percent);
  } else {
    Serial.println("MOTOR 1 FORWARD OFF!");
    motor_1_coast();
  }
  if (time_spent_this_rotation_us >= melty_parameters.motor_start_phase_2 || time_spent_this_rotation_us <= melty_parameters.motor_stop_phase_2) {
    Serial.println("MOTOR 2 FORWARD ON!");
    Serial.print("time_spent_this_rotation_us"); Serial.println(time_spent_this_rotation_us);
    Serial.print("melty_parameters.motor_start_phase_2: "); Serial.println(melty_parameters.motor_start_phase_2);
    Serial.print("melty_parameters.motor_stop_phase_2: "); Serial.println(melty_parameters.motor_stop_phase_2);
    motor_2_on(melty_parameters.throttle_percent);
  } else {
    Serial.println("MOTOR 2 FORWARD OFF!");
    motor_2_coast();
  }
}

//handle translating backward (motor1 and motor2 timings are swapped - offset by 180 degrees)
static void translate_backward(struct melty_parameters_t melty_parameters, unsigned long time_spent_this_rotation_us) {
  Serial.println("TRANSLATING BACKWARD!");
  if (time_spent_this_rotation_us >= melty_parameters.motor_start_phase_2 || time_spent_this_rotation_us <= melty_parameters.motor_stop_phase_2) {
    motor_1_on(melty_parameters.throttle_percent);
  } else {
    motor_1_coast();
  }
  if (time_spent_this_rotation_us >= melty_parameters.motor_start_phase_1 && time_spent_this_rotation_us <= melty_parameters.motor_stop_phase_1) {
    motor_2_on(melty_parameters.throttle_percent);
  } else {
    motor_2_coast();
  }
}

//turns on heading LED at appropriate timing
static void update_heading_led(struct melty_parameters_t melty_parameters, unsigned long time_spent_this_rotation_us) {
  if (melty_parameters.led_start > melty_parameters.led_stop) {
    if (time_spent_this_rotation_us >= melty_parameters.led_start || time_spent_this_rotation_us <= melty_parameters.led_stop) {
      heading_led_on(melty_parameters.led_shimmer);
    } else {
      heading_led_off();
    }
  } else {
    if (time_spent_this_rotation_us >= melty_parameters.led_start && time_spent_this_rotation_us <= melty_parameters.led_stop) {
      heading_led_on(melty_parameters.led_shimmer);
    } else {
      heading_led_off();
    }
  }
}

//rotates the robot once + handles translational drift
//(repeat as needed)
void spin_one_rotation(void) {

  //-initial- assignment of melty parameters
  static struct melty_parameters_t melty_parameters = get_melty_parameters();

  //capture initial time stamp before rotation start (time performing accel sampling / floating point math is included)
  unsigned long start_time = micros();
  unsigned long time_spent_this_rotation_us = 0;

  //tracking cycle count is needed to alternate cycles for non-translation (overflow is non-issue)
  static unsigned long cycle_count = 0;
  cycle_count++;

  //the melty parameters are updated either at the beginning of the rotation - or the middle of the rotation (alternating each time)
  //this is done so that any errors due to the ~1ms accel read / math cycle cancel out any effect on tracking / translational drift
  int melty_parameter_update_time_offset_us = 0;
  if (cycle_count % 2 == 1) melty_parameter_update_time_offset_us = melty_parameters.rotation_interval_us / 2;  
  bool melty_parameters_updated_this_rotation = false;

  //loop for one rotation of robot
  while (time_spent_this_rotation_us < melty_parameters.rotation_interval_us) {

    //update melty parameters if we haven't / update time has elapsed
    if (melty_parameters_updated_this_rotation == false && time_spent_this_rotation_us > melty_parameter_update_time_offset_us) { 
      melty_parameters = get_melty_parameters();
      melty_parameters_updated_this_rotation = true;
    }

    //if translation direction is RC_FORBACK_NEUTRAL - robot cycles between forward and reverse translation for net zero translation
    //if motor 2 (or motor 1) is not present - control sequence remains identical (signal still generated for non-connected motor)

    //translate forward
    if (melty_parameters.translate_forback == RC_FORBACK_FORWARD || (melty_parameters.translate_forback == RC_FORBACK_NEUTRAL && cycle_count % 2 == 0)) {
      translate_forward(melty_parameters, time_spent_this_rotation_us);
    }

    //translate backward
    if (melty_parameters.translate_forback == RC_FORBACK_BACKWARD || (melty_parameters.translate_forback == RC_FORBACK_NEUTRAL && cycle_count % 2 == 1)) {
      translate_backward(melty_parameters, time_spent_this_rotation_us);
    }

    //displays heading LED at correct location
    if (melty_parameters.rotation_interval_us != MAX_TRACKING_ROTATION_INTERVAL_US) {
      update_heading_led(melty_parameters, time_spent_this_rotation_us);
    }

    time_spent_this_rotation_us = micros() - start_time;

  }
}

//poorly allows for movement like a normal two wheeled bot - Cai
void two_wheel_drive(){
    float speed_scalar = 1.0f;
    float leftright_percent = (float)(rc_get_leftright()+500)/10.0f;
    Serial.print("leftright_percent: "); Serial.println(leftright_percent);
    motor_1_on(speed_scalar*leftright_percent/100);
    motor_2_on(speed_scalar*rc_get_throttle_percent()/100);
    Serial.print("speed_scalar*rc_get_throttle_percent()/100: "); Serial.println(speed_scalar*rc_get_throttle_percent()/100);
}
