SiwenJadenLong/CRB-Department-of-Donuts/Donut of Doom/CODE (openmelt2-main)/openmelt/motor_driver.cpp

//this module handles interfacing to the motors

#include "arduino.h"
#include "melty_config.h"
#include "motor_driver.h"


//motor_X_on functions are used for the powered phase of each rotation
//motor_X_coast functions are used for the unpowered phase of each rotation
//motor_X_off functions are used for when the robot is spun-down

void motor_on(float throttle_percent, int motor_pin) {

  if (THROTTLE_TYPE == BINARY_THROTTLE) {
    digitalWrite(motor_pin, HIGH);
  }

  if (THROTTLE_TYPE == FIXED_PWM_THROTTLE) {
    Serial.println("TRIED TO TURN MOTOR ON");
    ledcWrite(motor_pin, PWM_MOTOR_ON);
  }

//If DYNAMIC_PWM_THROTTLE - PWM is scaled between PWM_MOTOR_COAST and PWM_MOTOR_ON
//Applies over range defined by DYNAMIC_PWM_THROTTLE_PERCENT_MAX - maxed at PWM_MOTOR_ON above this
  if (THROTTLE_TYPE == DYNAMIC_PWM_THROTTLE) {
    float throttle_pwm = PWM_MOTOR_COAST + ((throttle_percent / DYNAMIC_PWM_THROTTLE_PERCENT_MAX) * (PWM_MOTOR_ON - PWM_MOTOR_COAST));
    if (throttle_pwm > PWM_MOTOR_ON) throttle_pwm = PWM_MOTOR_ON;
    ledcWrite(motor_pin, throttle_pwm);
  }
}

void motor_1_on(float throttle_percent) {
  motor_on(throttle_percent, MOTOR_PIN1);
}

void motor_2_on(float throttle_percent) {
  motor_on(throttle_percent, MOTOR_PIN2);
}

void motor_coast(int motor_pin) {
  if (THROTTLE_TYPE == FIXED_PWM_THROTTLE || THROTTLE_TYPE == DYNAMIC_PWM_THROTTLE) {
    ledcWrite(motor_pin, PWM_MOTOR_COAST);
  }
  if (THROTTLE_TYPE == BINARY_THROTTLE) {
    digitalWrite(motor_pin, LOW);  //same as "off" for brushed motors
  }
}

void motor_1_coast() {
  motor_coast(MOTOR_PIN1);
}

void motor_2_coast() {
  motor_coast(MOTOR_PIN2);
}

void motor_off(int motor_pin) {
  if (THROTTLE_TYPE == FIXED_PWM_THROTTLE || THROTTLE_TYPE == DYNAMIC_PWM_THROTTLE) {
    Serial.println("TRIED TO TURN MOTOR OFF");
    ledcWrite(motor_pin, PWM_MOTOR_OFF);
  }
  if (THROTTLE_TYPE == BINARY_THROTTLE) {
    digitalWrite(motor_pin, LOW);  //same as "off" for brushed motors
  }
}

void motor_1_off() {
  motor_off(MOTOR_PIN1);
}

void motor_2_off() {
  motor_off(MOTOR_PIN2);
}

void motors_off() {
  motor_1_off();
  motor_2_off();
}

int FREQ = 60;
int RESOLUTION = 8;

void init_motors() { //REWRITE ALL THE CODE TO HAVE CLEANER TELEMETRY AND ALSO TO WRITE PWM WITH LEDC
  //ledcAttachChannel(ledPin, freq, resolution, 0);
  ledcAttach(MOTOR_PIN1, FREQ, RESOLUTION);
  ledcAttach(MOTOR_PIN2, FREQ, RESOLUTION);
  motors_off();
}
