SiwenJadenLong/CRB-Department-of-Donuts/Donut of Doom/CODE (openmelt2-main)/openmelt/accel_handler.h

#include "SparkFun_LIS331.h"

//Set high enough to allow for G forces at top RPM
//LOW_RANGE - +/-100g for the H3LIS331DH
//MED_RANGE - +/-200g for the H3LIS331DH
//HIGH_RANGE - +/-400g for the H3LIS331DH
#define ACCEL_RANGE LIS331::HIGH_RANGE   

//Set to correspond to ACCEL_RANGE
#define ACCEL_MAX_SCALE 400

//Change as needed as needed
//(Adafuit breakout default is 0x18, Sparkfun default is 0x19)
#define ACCEL_I2C_ADDRESS 0x18

void init_accel();

float get_accel_force_g();
