SiwenJadenLong/CRB-Department-of-Donuts/Donut of Doom/PICO 2 CODE/Pico 2 ELRS Test/src/main.cpp

#include <Arduino.h>

// put function declarations here:
int myFunction(int, int);

void setup() {
  // put your setup code here, to run once:
  int result = myFunction(2, 3);
  Serial.begin(9600);
}

void loop() {
  // put your main code here, to run repeatedly:
  Serial.print(myFunction(2, 3));
}

// put function definitions here:
int myFunction(int x, int y) {
  return x + y;
}
