SiwenJadenLong/CRB-Department-of-Donuts/(commit log)

2025-09-25 created schematic project
    [Donut of Doom.kicad_pcb, Donut of Doom.kicad_sch]
2025-09-25 rearranged folders
    [Donut of Doom.kicad_pcb, Donut of Doom.kicad_sch]
2025-09-27 open melt2 code is here
    [lid.stl, openmelt_schematic.kicad_pcb, openmelt_schematic.kicad_sch, shell_no_weapon.stl, shell_with_weapon.stl, spinbot_ant.scad, weapon.stl, weapon_pin.stl]
2025-09-29 ITS WORKING
    BUT TO GET IT TO COMPILE I HAD TO CHANGE THE NAME OF OPEN_DRAIN at "C:\Users\CAIS\Documents\Arduino\libraries\arduino-esp32-master\cores\esp32\esp32-hal-gpio.c" and "C:\Users\CAIS\Documents\Arduino\libraries\arduino-esp32-master\cores\esp32\esp32-hal-gpio.h" to ESP32OPEN_DRAIN wherever it appears (and I changed the Sparkfun variable to a sparkfun version as well which can be found in the sparkfun library)
2025-09-30 Switched to FIXED_PWM_THROTTLE
2025-10-03 robot should be able to move forward and also spin poorly with one wheel to turn
2025-10-07 Added Custom Symbol Library and worked more on Schematic
    [Donut of Doom.kicad_sch]
2025-10-18 GETTING STUCK IN THROTTLE/RC LOOP EVEN THOUGH BOTH ARE VALID, ACCELEROMETER IS NOT CONNECTING PROPERLY
    [accel_handler.h, melty_config.h, openmelt.ino]
2025-10-19 Motor is spinning when throttle is increased only when ESP32 is on but ESP32 says it is waiting for the RC to come online which makes no sense because then how is the motor receiver the transmitter's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
2025-10-19 Motor is spinning when throttle is increased only when ESP32 is on but ESP32 says it is waiting for the RC to come online which makes no sense because then how is the motor receiving the transmitter'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
2025-11-01 NEED to rewrite code to use esp32 servo library to change
2025-11-02 melty code working maybe need to make sure motor doesn't explode
    [melty_config.h, motor_driver.cpp, openmelt.ino]
2025-11-02 ITS WORKING THE MOTOR DIDN'T BLOW UP
    [melty_config.h, openmelt.ino, spin_control.cpp]
2025-11-06 TEST THIS - throttle failsafe if transmitters turns off
    [openmelt.ino]
2025-11-15 ACCELEROMETER AXIS MAY HAVE BEEN INCORRECT
2025-11-28 Started a lot of work on DOD V2 PCB with the Pico 2
    [Donut of Doom.kicad_sch, led_strip.kicad_sch]
2025-11-28 Added voltage spike protection circuitry to ESCs
    [Donut of Doom.kicad_sch]
2025-11-29 fixed accel pins
    [Donut of Doom.kicad_sch]
2025-12-02 Made draft pcb for Plant Donut V2
    [Donut of Doom.kicad_pcb, Donut of Doom.kicad_sch]
2025-12-02 debug resistor and led finalized, export tested for dfm
    [Donut of Doom-B_Cu.gbr, Donut of Doom-B_Mask.gbr, Donut of Doom-B_Paste.gbr, Donut of Doom-B_Silkscreen.gbr, Donut of Doom-Edge_Cuts.gbr, Donut of Doom-F_Cu.gbr, Donut of Doom-F_Mask.gbr, Donut of Doom-F_Paste.gbr]
2026-01-15 New footprints for buck and accel, layout partially done.
    [Adafruit_H3LIS331.kicad_sch, Donut of Doom v1.step, Donut of Doom.kicad_pcb, Donut of Doom.kicad_sch, H3LIS331DLTR.step, MSMP package.step]
2026-01-17 PCB almost finalized, awaiting dfm
    [Adafruit_H3LIS331.kicad_sch, Donut of Doom v1.step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]
2026-01-18 Finalized V1 Order, DFM completed
    [Donut of Doom.kicad_pcb, Donut of Doom.kicad_sch]
2026-01-31 fixed resistor values
    [Adafruit_H3LIS331.kicad_sch, Donut of Doom Order 1.step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]
2026-02-01 Added more breakouts, corrected MOSFET, better esc and led pads.
    [Adafruit_H3LIS331.kicad_sch, Donut of Doom.kicad_pcb, Donut of Doom.kicad_sch]
2026-02-01 Added better GND connections and Labels
    [Donut of Doom.kicad_pcb, Donut of Doom.kicad_sch]
2026-03-24 Turned accelorometer 45 degrees, increased clearence on elrs reciever
    [Donut of Doom.kicad_pcb, Donut of Doom.kicad_sch]
2026-03-24 Added 2nd accel, fixed mosfet, added more GND pads
    [Adafruit_H3LIS331.kicad_sch, Donut of Doom.kicad_pcb, Donut of Doom.kicad_sch]
2026-03-24 small silkscreen fixes
    [Donut of Doom.kicad_pcb]
2026-03-25 added teardrops
    [Donut of Doom.kicad_pcb]
2026-03-25 fixed lower accelerameter routing
    [Donut of Doom.kicad_pcb]
2026-03-25 fixed dead copper
    [Donut of Doom.kicad_pcb]
2026-06-29 V3 First rev finished
    [Adafruit_H3LIS331.kicad_sch, Donut of Doom.kicad_pcb, Donut of Doom.kicad_sch]
2026-07-04 fixed accelerameter positons
    [Donut of Doom.kicad_pcb]
2026-07-06 New resistor calculations for 6s HV
    [Donut of Doom.kicad_pcb, Donut of Doom.kicad_sch]
